Makerspace-Amiens-2025-26/Puzzle-Bot-Groupe04/CODES PROJET ROBOT/calib_1.png

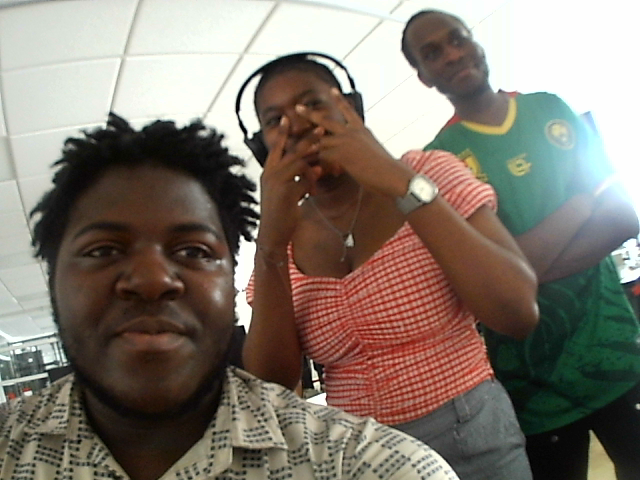
CODES PROJET ROBOT/calib_1.png
