Makerspace-Amiens-2025-26/Puzzle-Bot-Groupe04/project/Matériels/IMG_9819.jpeg

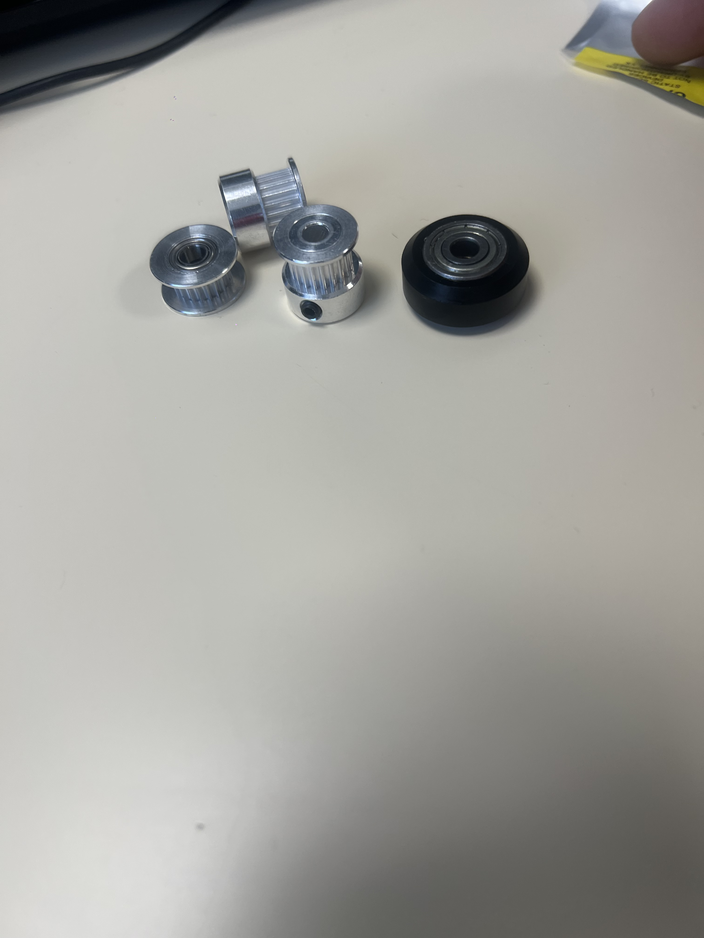
project/Matériels/IMG_9819.jpeg
