Makerspace-Amiens-2025-26/Puzzle-Bot-Groupe04/project/Matériels/IMG_9822.jpeg

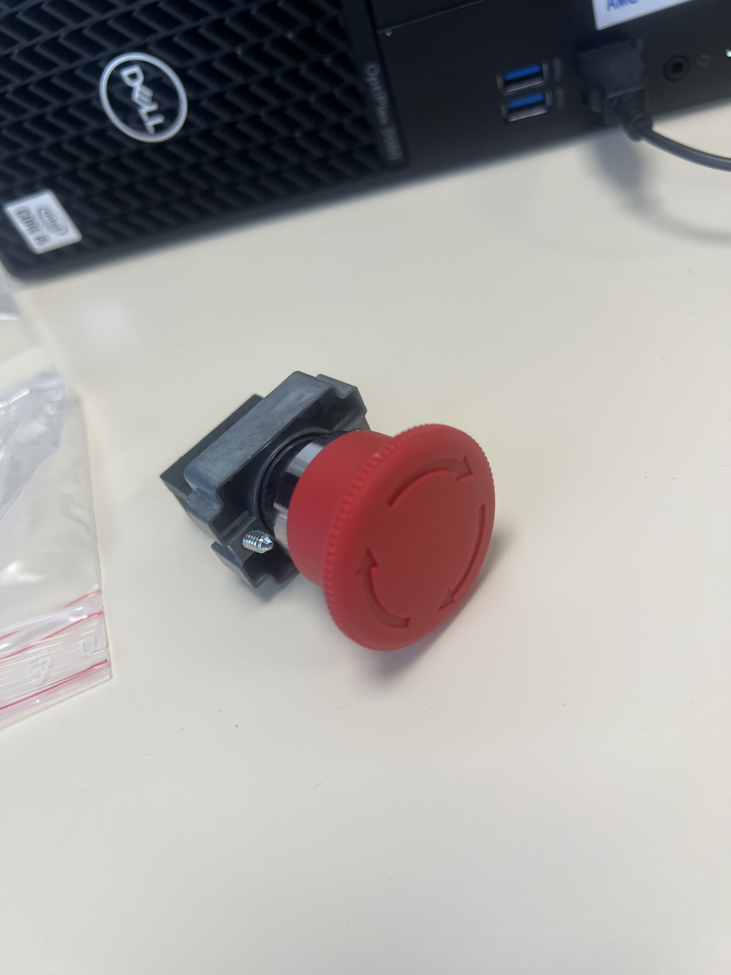
project/Matériels/IMG_9822.jpeg
