Makerspace-Amiens-2025-26/Puzzle-Bot-Groupe04/project/Matériels/ssj/Capture d’écran_21-5-2026_94810_cad.onshape.com.jpeg

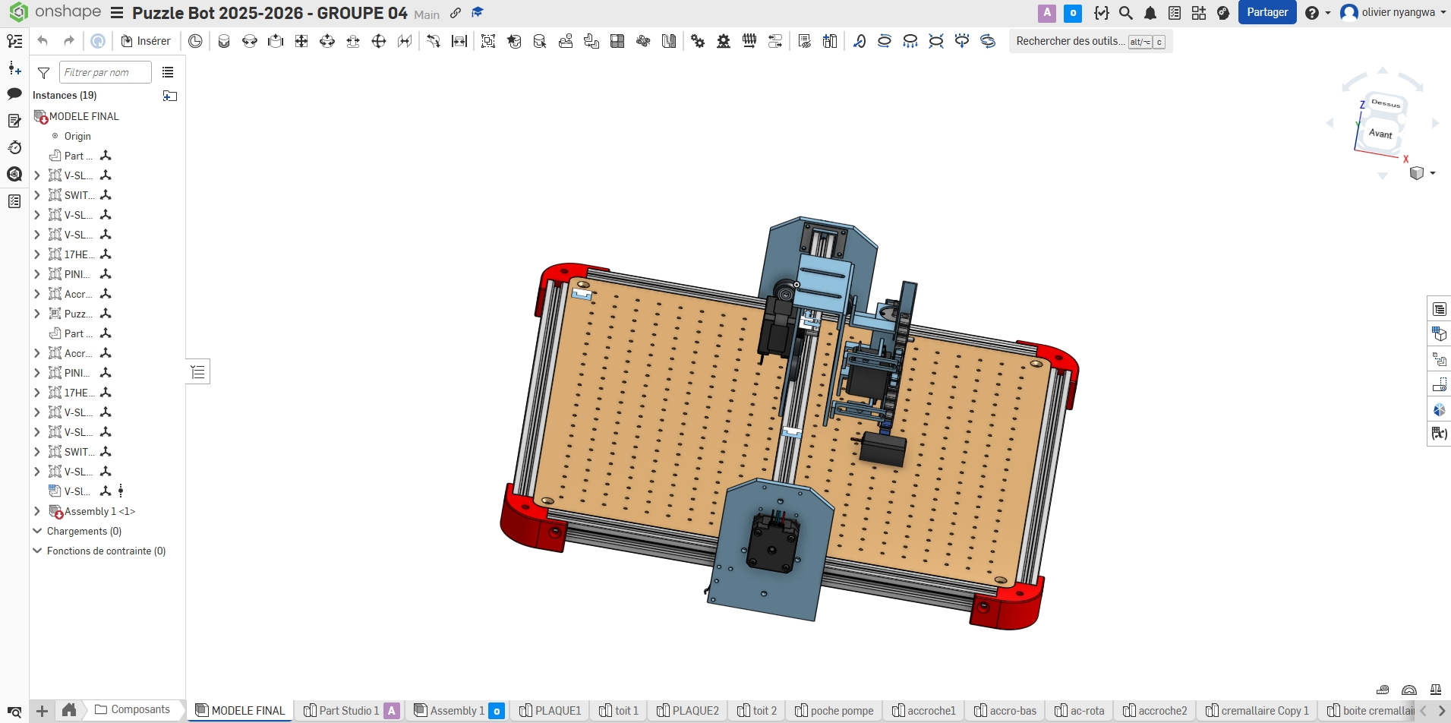
project/Matériels/ssj/Capture d’écran_21-5-2026_94810_cad.onshape.com.jpeg
