Makerspace-Amiens-2025-26/Puzzle-Bot-Groupe04/CODES PROJET ROBOT/calibration_camera/calib_6.png

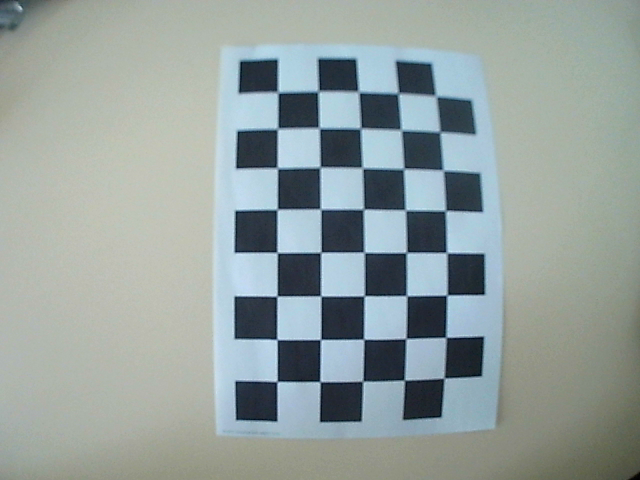
CODES PROJET ROBOT/calibration_camera/calib_6.png
