Makerspace-Amiens-2025-26/Puzzle-Bot-Groupe04/CODES PROJET ROBOT/calibration_camera/calib_8.png

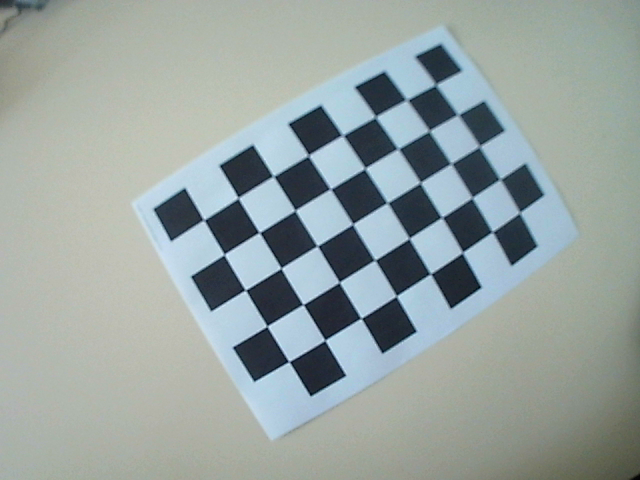
CODES PROJET ROBOT/calibration_camera/calib_8.png
