Makerspace-Amiens-2025-26/Puzzle-Bot-Groupe04/(commit log)

2026-06-15 Rename Capture d’écran 2026-06-05 164930.png to Boitier STOP.png
2026-06-15 Rename Capture d’écran 2026-06-05 165814.png to arduino_integ.png
2026-06-15 Rename Capture d’écran 2026-06-05 165851.png to arduino_berceau.png
2026-06-15 Rename Capture d’écran 2026-06-05 170211.png to adaptateur_servo.png
2026-06-15 Rename Capture d’écran 2026-06-05 170418.png to pignon.png
2026-06-15 Rename Capture d’écran 2026-06-05 170537.png to cremaillere.png
2026-06-15 Rename Capture d’écran 2026-06-05 170631.png to guidage_1.png
2026-06-15 Rename Capture d’écran 2026-06-05 170652.png to guidage_2.png
2026-06-15 Rename Capture d’écran 2026-06-05 171159.png to boitier_pneumatique.png
2026-06-15 Rename Capture d’écran 2026-06-05 171434.png to chariot_face.png
2026-06-15 Rename Capture d’écran 2026-06-05 171511.png to chariot_dos.png
2026-06-15 Rename Capture d’écran 2026-06-05 171739.png to support_ancrage.png
2026-06-15 Rename Capture d’écran 2026-06-05 172023.png to fin_de_course.png
2026-06-15 Rename Capture d’écran 2026-06-05 172219.png to equerre_vision.png
2026-06-15 Rename Capture d’écran 2026-06-05 172246.png to manchon_vision.png
2026-06-15 Rename Capture d’écran 2026-06-05 172333.png to cube_vision.png
2026-06-15 Rename Capture d’écran 2026-06-05 172517.png to camera_boitier.png
2026-06-15 Rename Capture d’écran 2026-06-05 172549.png to camera_couvercle.png
2026-06-15 Rename Capture d’écran 2026-06-05 172935.png to puzzlebot_complet.png
2026-06-15 Rename Capture d’écran 2026-06-05 164804.png to stop_couvercle.png
